mateuszwicinski/Awionika-SimBa/README.md

<h1>Awionika-SimBa - Modułowy komputer pokładowy rakiety (Altium Designer)</h1>

Projekt modułowego systemu elektroniki rakietowej wykonany w środowisku Altium Designer. Całość została zaprojektowana w formie 3-poziomowego, okrągłego stosu płytek drukowanych, dostosowanego kształtem do montażu wewnątrz kadłuba rakiety.

Poszczególne płytki łączą się ze sobą za pomocą złącz szpilkowych (goldpin), które przekazują linie zasilania oraz sygnały sterujące między poziomami.

<h2>Opis modułów systemu</h2>

<h3>Płytka dolna (Zasilanie i układy wykonawcze)</h3>

Odpowiada za zasilanie całego stosu oraz załączanie elementów wykonawczych:

Zasilanie: przetwornica step-down D30V30F5 dostarczająca główną linię 5V oraz stabilizator liniowy AMS1117 dla linii 3.3V. Wejście zasilania ze złącza XT30 lub ARK z diodą zabezpieczającą przed odwrotną polaryzacją.

Obwód zapalnika odzysku: wyjście śrubowe ARK sterowane tranzystorem N-MOSFET (AO3400A) z rezystorem ściągającym bramkę do masy. W gałąź zapalnika wpięty jest szeregowo bezpiecznik polimerowy 2.6A (0ZCG0260BF2B), którego zadaniem jest odcięcie dopływu prądu do zapalnika po zadziałaniu ładunku w razie zwarcia lub stopienia drutu oporowego, co chroni akumulator przed przeciążeniem i zapobiega wyłączeniu reszty elektroniki.

Obwód buzzera: tranzystor N-MOSFET (AO3400A) z diodą gaszącą impulsy indukcyjne (SS14) do załączania buzzera akustycznego po wylądowaniu.

Wyjścia serwomechanizmów: złącza JST-XH wyprowadzające linie zasilania 5V, masę oraz sygnały sterujące PWM.

<h3>Płytka środkowa (Logika i pamięć)</h3>

Główny moduł sterujący:

Mikrokontroler: płytka deweloperska ESP32-C3-Zero, połączona z magistralą między płytkami.

Karta pamięci: gniazdo modułu czytnika kart MicroSD (Waveshare) połączone przez interfejs SPI do zapisu parametrów lotu w czasie rzeczywistym.

<h3>Płytka górna (Sensory i łączność radiowa)</h3>

Moduł pomiarowy i komunikacyjny:

Moduł radiowy: LoRa z wyprowadzeniem pinu antenowego bezpośrednio do złącza antenowego J6.

Czujniki: pola pod moduł barometru oraz moduł czujnika IMU podłączone pod magistralę I2C/SPI.

Zawartość repozytorium

<h2>Dokumenty:</h2>

Schematy ideowe w formacie PDF dla każdego z trzech modułów.

Zestawienia komponentów (BOM) w formacie CSV.

Zrzuty i rendery 3D płytek drukowanych.

<h2>Fabryka:</h2>

Spakowane archiwa (ZIP) z plikami Gerber (warstwy miedzi, soldermaski, opisów i obrysu) oraz plikami wierceń maszynowych (NC Drill).

<h2>Projekty:</h2>

Pliki projektowe Altium Designer (.PrjPcb, .SchDoc, .PcbDoc).

Biblioteki symboli (.SchLib) oraz footprintów (.PcbLib) utworzone na potrzeby projektu.

<h2>Płytka logiki</h2>

Plytka_srodkowa_ESP_SD(bok1)

Plytka_srodkowa_ESP_SD(bok2)

Plytka_srodkowa_ESP_SD(tył)

Plytka_srodkowa_ESP_SD

<h2>Płytka LORA</h2>

Plytka_gorna_lora_czujniki(bok1)

Plytka_gorna_lora_czujniki(bok2)

Plytka_gorna_lora_czujniki(tyl)

Plytka_gorna_lora_czujniki

<h2>Płytka power</h2>

Plytka_dolna_power(bok1)

Plytka_dolna_power(bok2)

Plytka_dolna_power(tyl)

Plytka_dolna_power
