mateuszwicinski/Awionika-SimBa/Dokumenty/Zdjęcia/Projekt_Logika/Plytka_srodkowa_ESP_SD(bok1).png

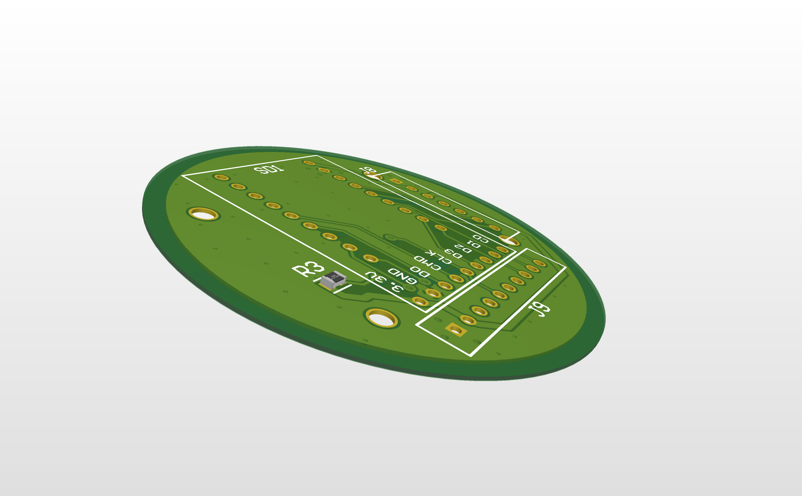
Dokumenty/Zdjęcia/Projekt_Logika/Plytka_srodkowa_ESP_SD(bok1).png
