mateuszwicinski/Awionika-SimBa/Dokumenty/Zdjęcia/Projekt_Logika/Plytka_srodkowa_ESP_SD(tył).png

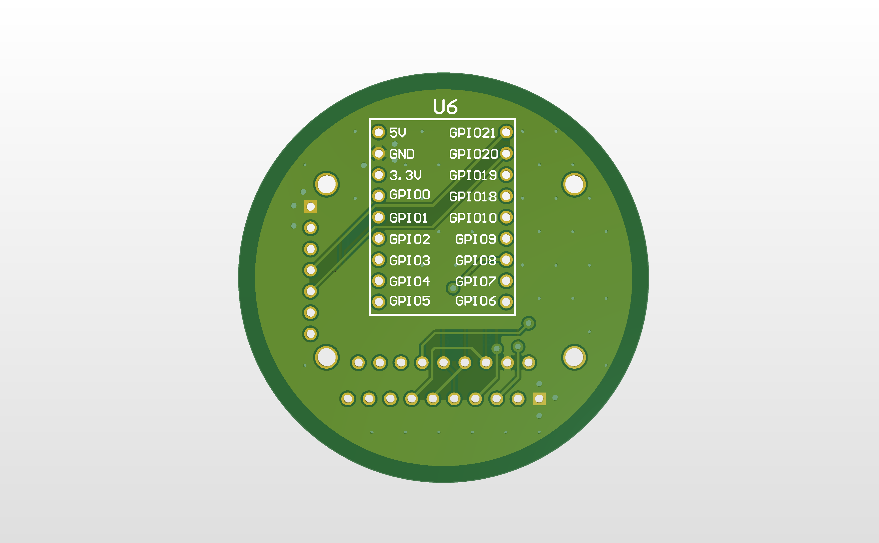
Dokumenty/Zdjęcia/Projekt_Logika/Plytka_srodkowa_ESP_SD(tył).png
