mateuszwicinski/Awionika-SimBa/Dokumenty/Zdjęcia/Projekt_LORA/Plytka_gorna_lora_czujniki(bok2).png

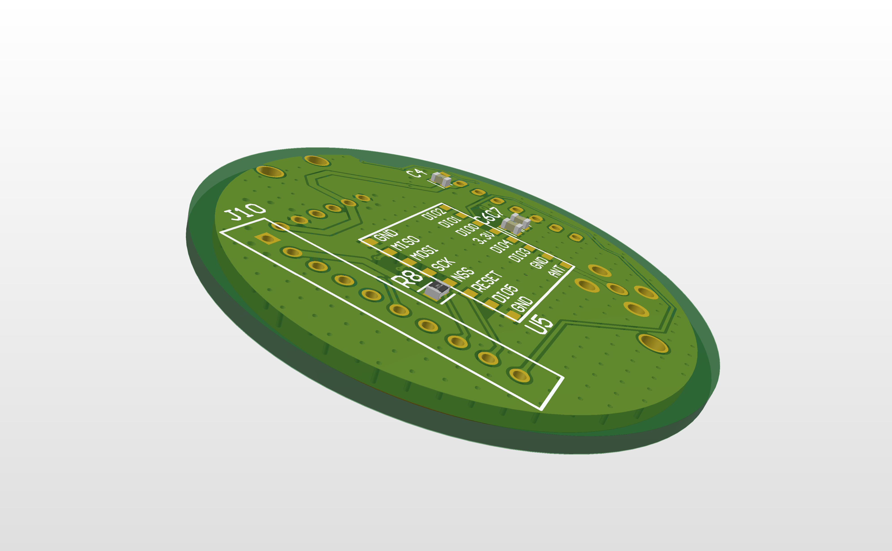
Dokumenty/Zdjęcia/Projekt_LORA/Plytka_gorna_lora_czujniki(bok2).png
