mateuszwicinski/Awionika-SimBa/Dokumenty/Zdjęcia/Projekt_LORA/Plytka_gorna_lora_czujniki(tyl).png

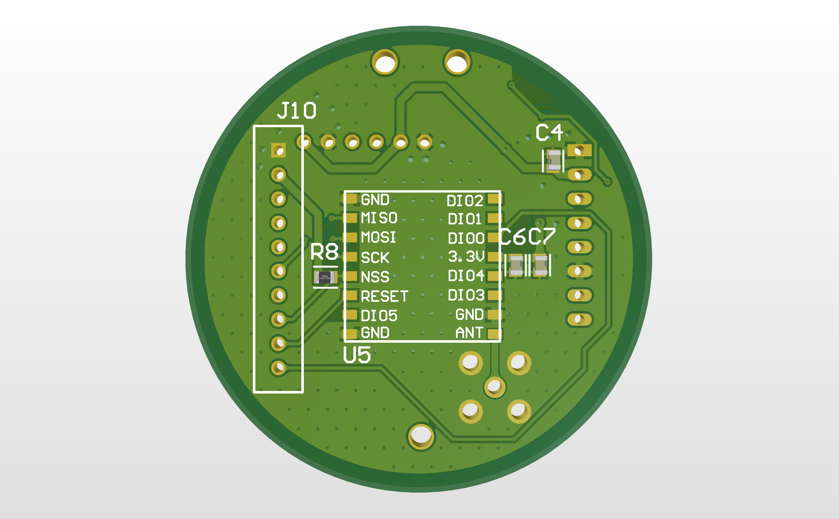
Dokumenty/Zdjęcia/Projekt_LORA/Plytka_gorna_lora_czujniki(tyl).png
