mateuszwicinski/Awionika-SimBa/Dokumenty/Zdjęcia/Projekt_LORA/Plytka_gorna_lora_czujniki.png

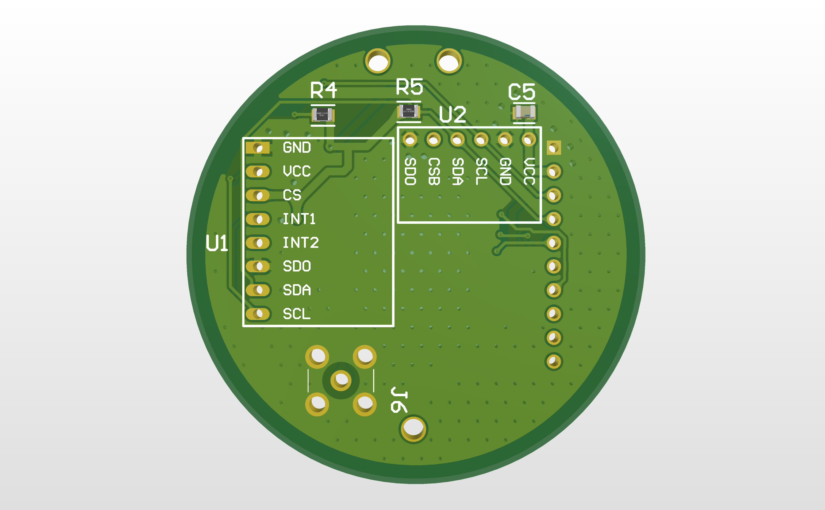
Dokumenty/Zdjęcia/Projekt_LORA/Plytka_gorna_lora_czujniki.png
