mateuszwicinski/Awionika-SimBa/Dokumenty/Zdjęcia/Projekt_Power/Plytka_dolna_power(bok1).png

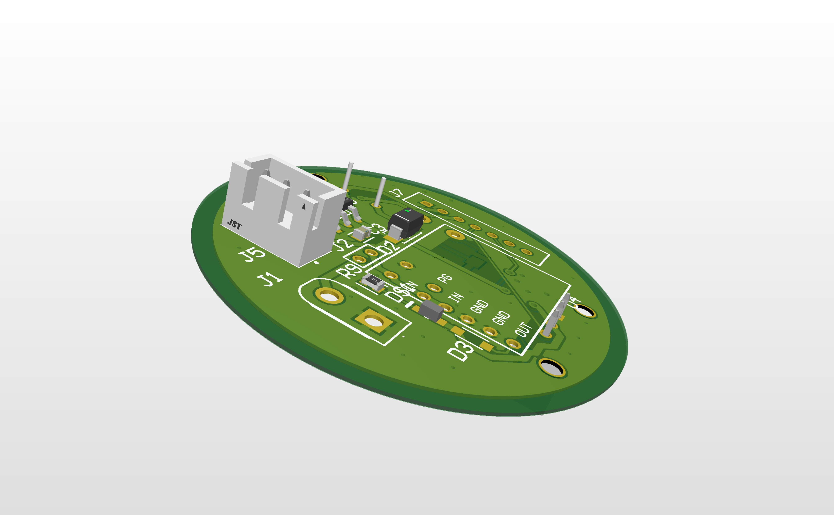
Dokumenty/Zdjęcia/Projekt_Power/Plytka_dolna_power(bok1).png
