mateuszwicinski/Awionika-SimBa/Dokumenty/Zdjęcia/Projekt_Power/Plytka_dolna_power(tyl).png

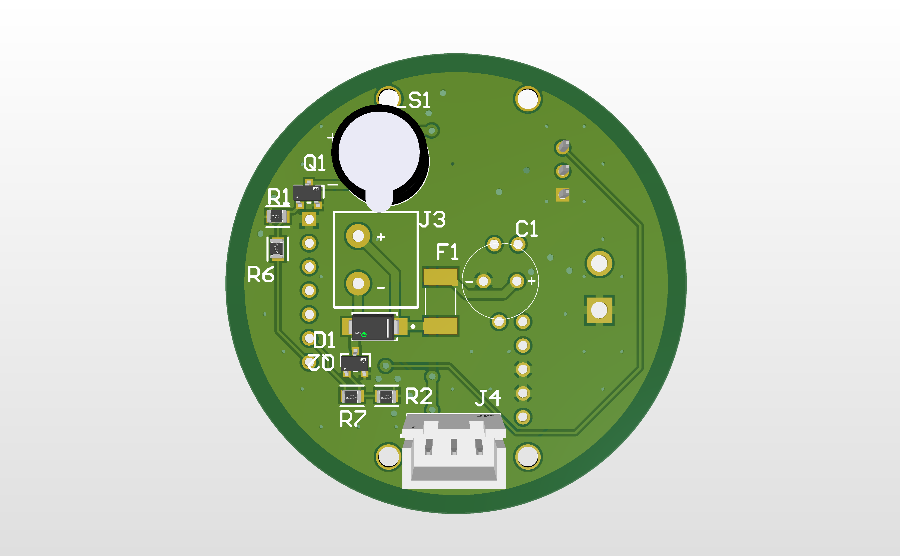
Dokumenty/Zdjęcia/Projekt_Power/Plytka_dolna_power(tyl).png
