mateuszwicinski/Awionika-SimBa/Dokumenty/BOM/Projekt_LORA.csv

Name | Description | Designator | Footprint | LibRef | Quantity
100nF | CAP CER 0.1UF 16V X7R 0805 | C4, C5, C7 | FP-C0805C-DN-MFG | CMP-2007-00274-2 | 3
10uF | CAP CER 10UF 16V X7R 0805 | C6 | FP-C0805C-DN-MFG | CMP-2007-00274-2 | 1
RF2-19A-T-00-50-G | Conn SMA 0Hz to 18GHz 50Ohm Solder ST Thru-Hole RCP Gold | J6 | RF219AT0050G | RF2-19A-T-00-50-G | 1
PrzejscieTHT10 |  | J10 | PrzejscieTHT10 | PrzejscieTHT10 | 1
4.7k? | CRGCQ 0805 4.7K 5% | R4, R5 | FP-CRGCQ0805-IPC_C | CMP-03211-002989-1 | 2
10k? | CRGCQ 0805 10K 5% | R8 | FP-CRGCQ0805-IPC_C | CMP-03211-002989-1 | 1
ADXL345 |  | U1 | ADXL345 | ADXL345 | 1
BMP280 |  | U2 | BMP280 | BMP280 | 1
RFM95W-868S2R |  | U5 | RFM95W-868S2R | RFM95W-868S2R | 1
