mateuszwicinski/Awionika-SimBa/Dokumenty/BOM/Projekt_Power.csv

Name | Description | Designator | Footprint | LibRef | Quantity
Kondensator_470uF/25V |  | C1 | Capacitor_470uF/25V | Kondensator_470uF/25V | 1
10uF | CAP CER 10UF 16V X7R 0805 | C2, C3 | FP-C0805C-DN-MFG | CMP-2007-00274-2 | 2
SS14 | DIODE SCHOTTKY 40V 1A SMA | D1, D2 | FP-403AE-MFG | CMP-2000-04943-2 | 2
SS34FA | UL Flammability 94V-0 Classification; MSL 1 per J-STD-020; Low Power Loss, High Efficiency; Guard Ring for Overvoltage Protection; RoHS Compliant / Green Molding Compound; High Surge Current Capability; NRVB Prefix for Automotive and Other Applications Requiring Unique Site and Control Change Requirements; AECQ101 Qualified and PPAP Capable | D3 | SODFL3618X143N | SS34FA | 1
KP-2012SGC | LED Green, 62.5 mW, 25 mA, -40 to 85 degC, 4-Pin SMD, RoHS, Tape and Reel | DS1, DS2 | KING-KP-2012SGC_V | CMP-2000-06517-1 | 2
0ZCG0260BF2B |  | F1 | FUSER_0ZCG0260BF2B | 0ZCG0260BF2B | 1
XT30PB-M | Brass Gold Plated Connector 0.65m , 500VDC , 15A , -20 to 120 | J1 | XT30PBM | XT30PB-M | 1
Zworka |  | J2 | Zworka | Zworka | 1
ARK_10A_300V |  | J3 | ARK_10A_300V | ARK_10A_300V | 1
B3B-XH-A(LF)(SN) | CONN HEADER VERT 3POS 2.5MM | J4, J5 | FP-B3B-XH-A_LF_SN-MFG | CMP-17439-000014-3 | 2
PrzejscieTHT |  | J7 | PrzejscieTHT | PrzejscieTHT | 1
LEB9055B-05B-2.7-5.0-R | AUDIO INDICATOR 3VDC 30MA 80DBA 2700HZ | LS1 | XDCR_AI-1027-TWT-3V-R | AI-1027-TWT-3V-R | 1
AO3400A | MOSFET N-CH 30V 5.7A SOT23 | Q1, Q2 | FP-SOT23-MFG | CMP-83955-000006-1 | 2
10k? | CRGCQ 0805 10K 5% | R1, R2 | FP-CRGCQ0805-IPC_C | CMP-03211-002989-1 | 2
100? | CRGCQ 0805 100 5% | R6, R7 | FP-CRGCQ0805-IPC_C | CMP-03211-002989-1 | 2
1k? | CRGCQ 0805 1K 5% | R9, R10 | FP-CRGCQ0805-IPC_C | CMP-03211-002989-1 | 2
ams1117 | 1A LOW DROPOUT VOLTAGE REGULATOR | U3 | FP-ams1117-IPC_C | CMP-209535-000002-1 | 1
D30V30F5 |  | U4 | D30V30F5 | D30V30F5 | 1
