mateuszwicinski/Awionika-SimBa/Projekty/Plytka_dolna_power.pdf

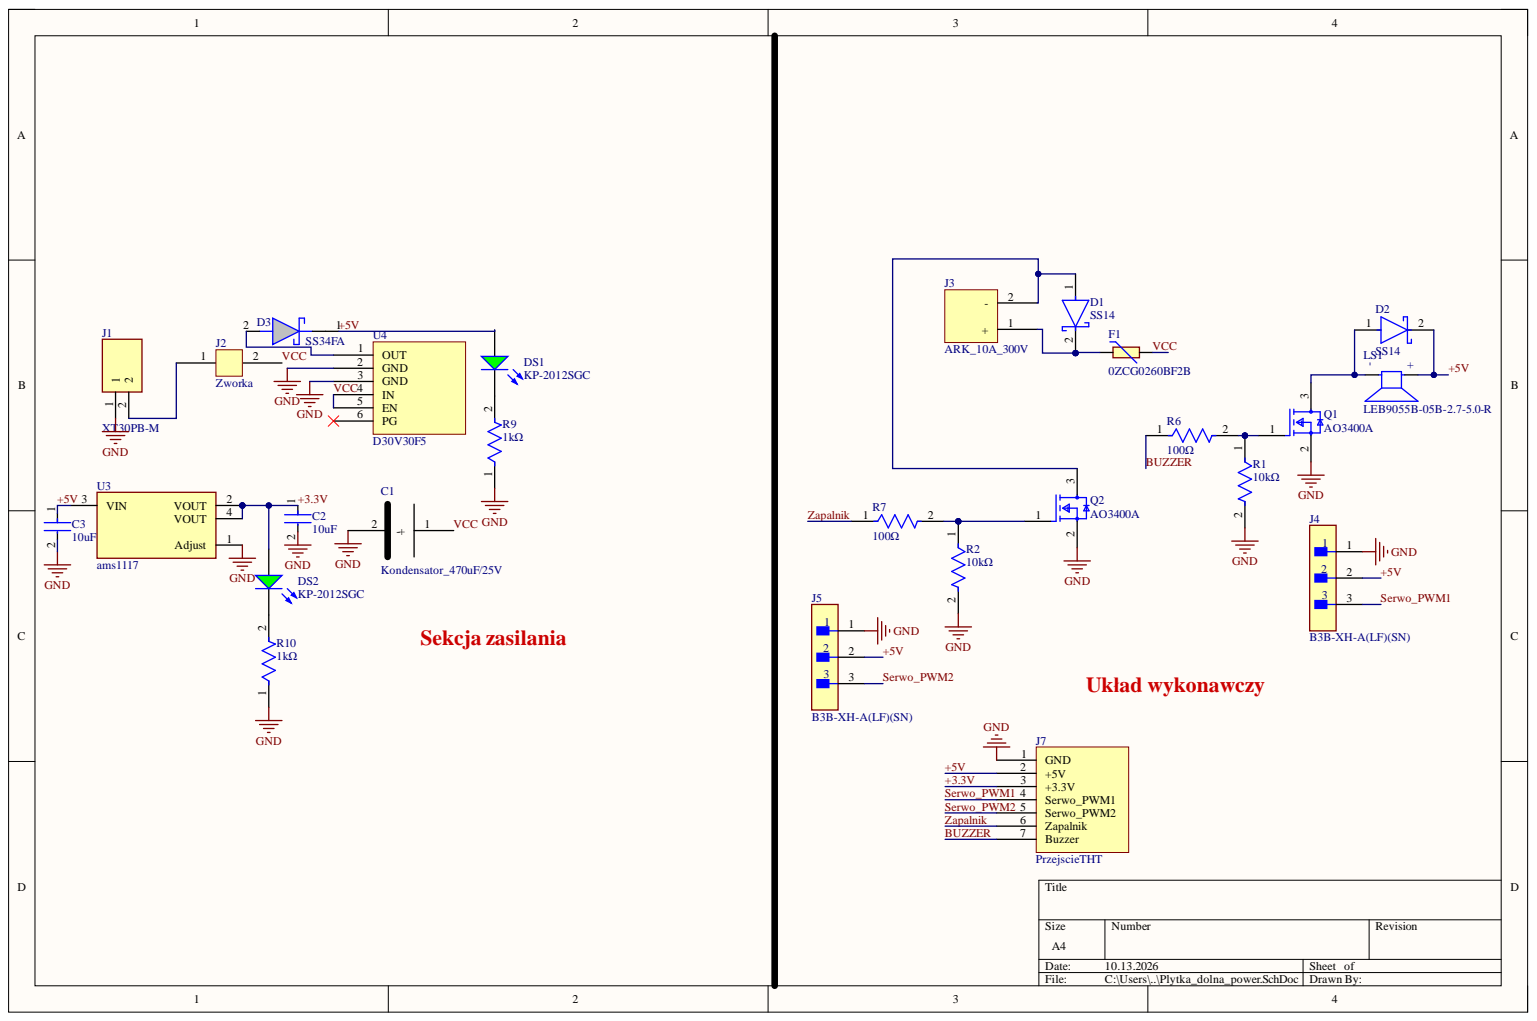
[picture p12: page 1]
