mateuszwicinski/Awionika-SimBa/Projekty/Plytka_gorna_lora_czujniki.pdf

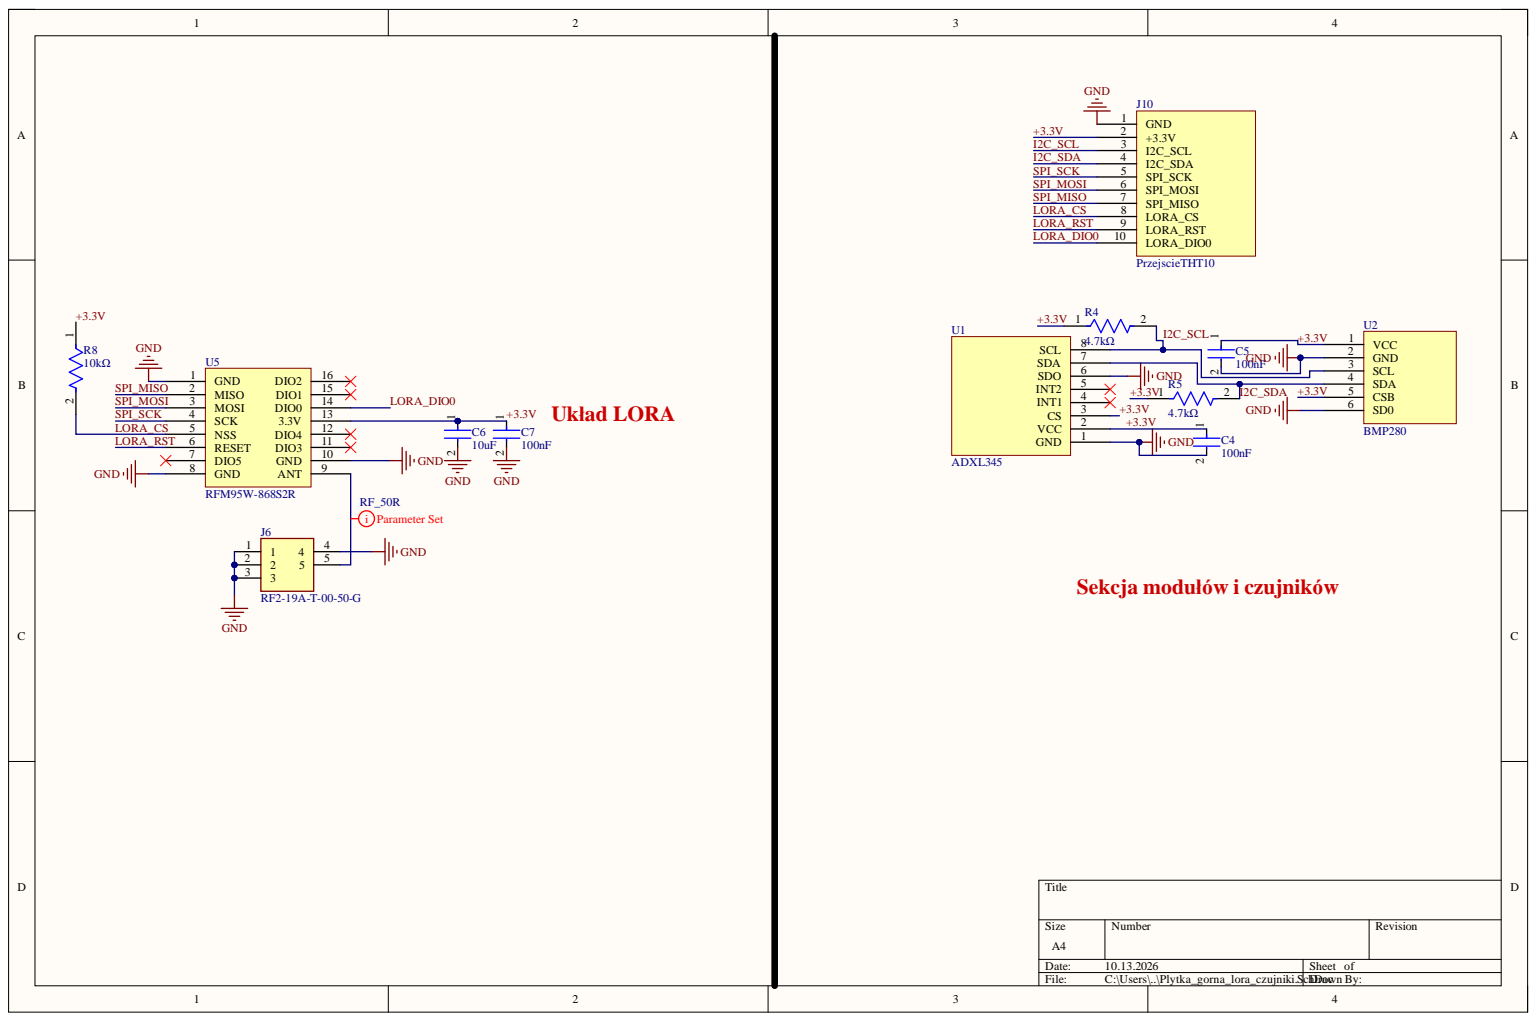
[picture p13: page 1]
