mateuszwicinski/Awionika-SimBa/Projekty/Plytka_srodkowa_ESP_SD.pdf

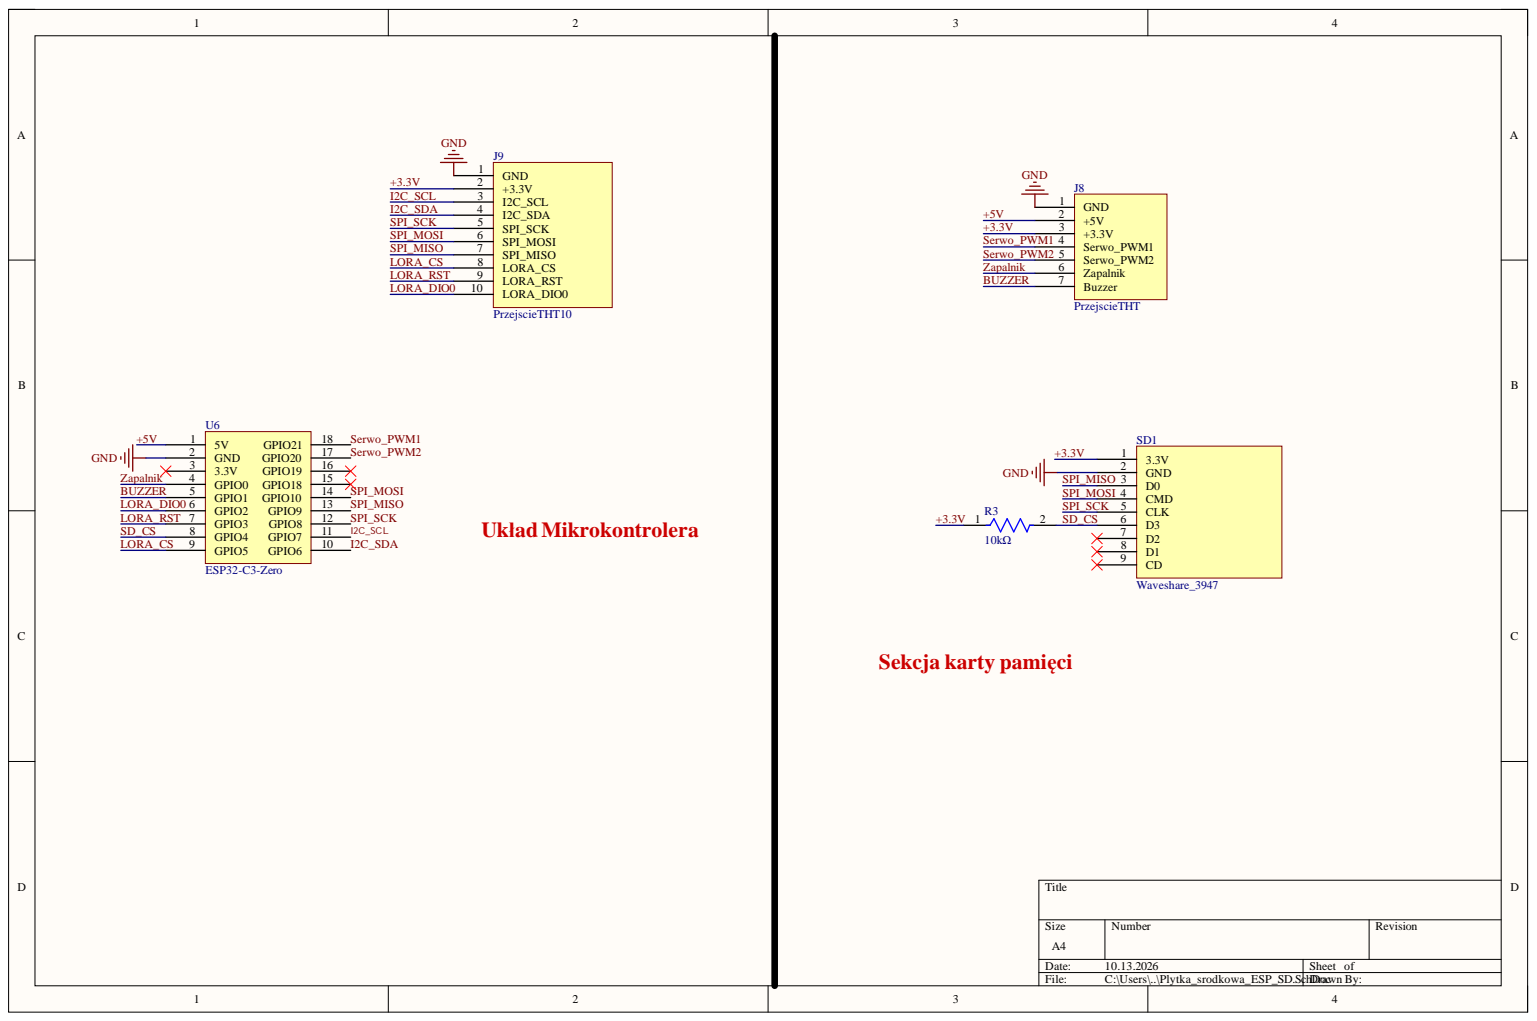
[picture p14: page 1]
