mateuszwicinski/Awionika-SimBa/Projekty/Projekt_Power.pdf

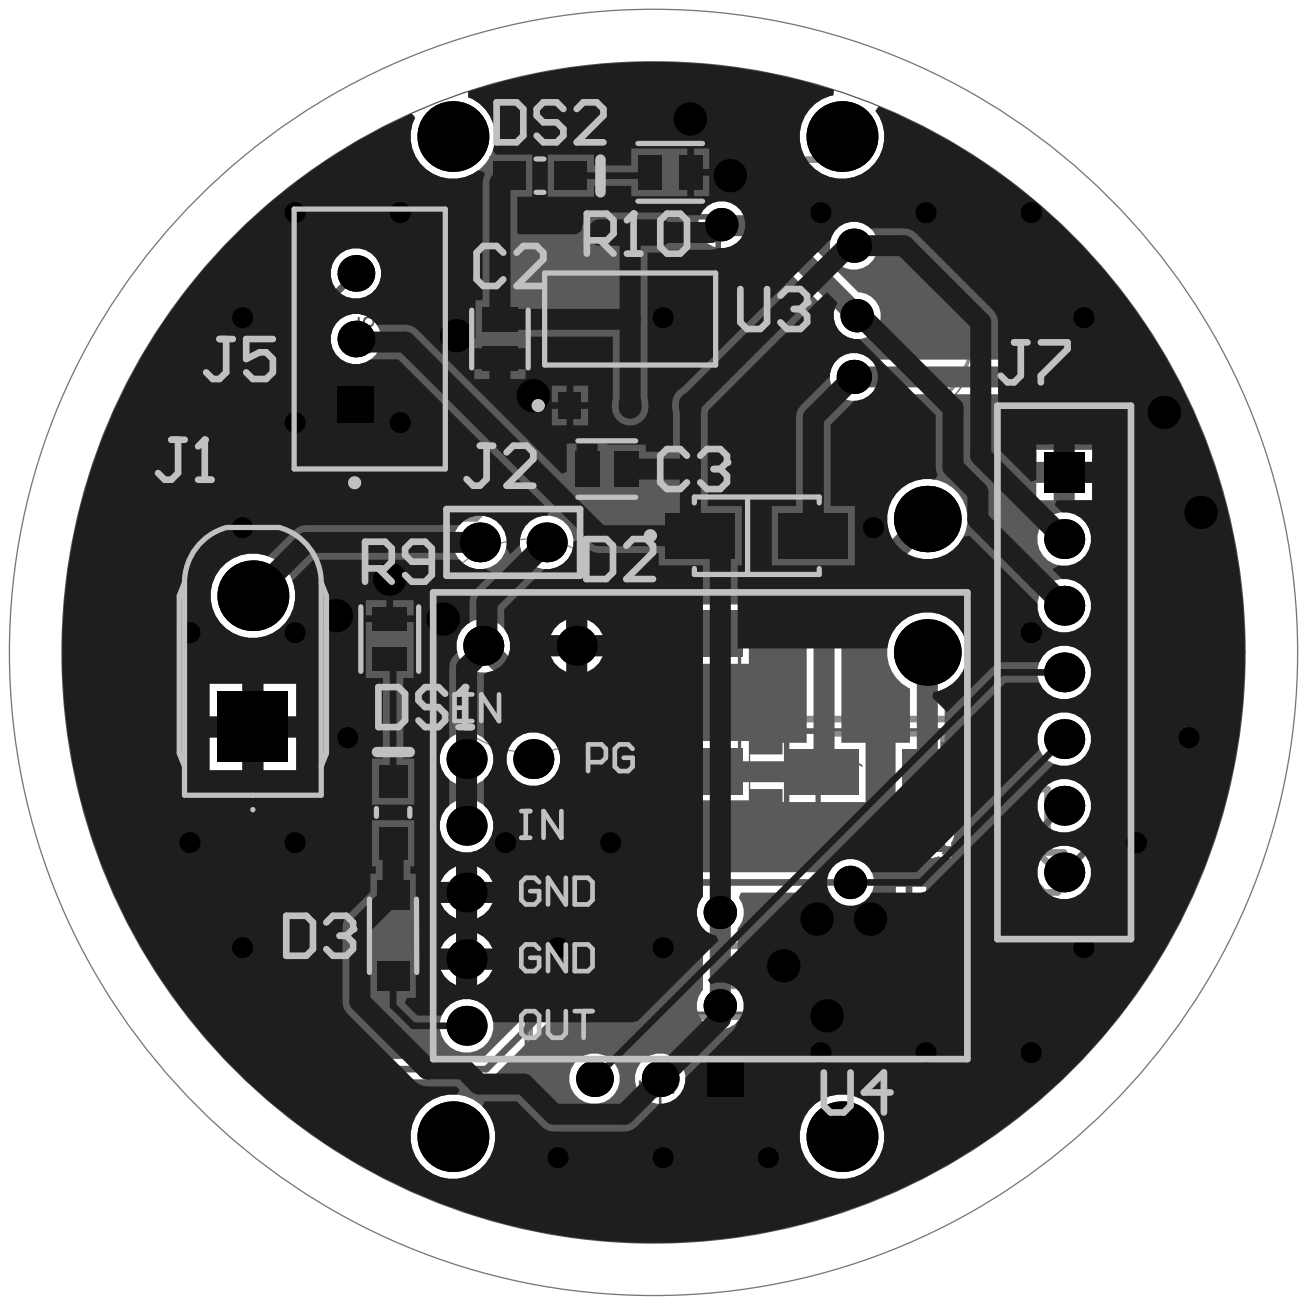
[picture p15: page 2]
