mateuszwicinski/Awionika-SimBa/(list of files, drawings)

Other design files:
Projekty/Akcelerometr.PcbLib
Projekty/Akcelerometr.SchLib
Projekty/Barometr.PcbLib
Projekty/Barometr.SchLib
Projekty/Buzzer.PcbLib
Projekty/Buzzer.SchLib
Projekty/CzytnikKartSD.PcbLib
Projekty/CzytnikKartSD.SchLib
Projekty/Kondensator_470uF_25V.PcbLib
Projekty/Kondensator_470uF_25V.SchLib
Projekty/LEB9055B-05B-2.7-5.0-R.PcbLib
Projekty/LEB9055B-05B-2.7-5.0-R.SchLib
Projekty/LORA.PcbLib
Projekty/LORA.SchLib
Projekty/Mikrokontroler.PcbLib
Projekty/Mikrokontroler.SchLib
Projekty/Plytka_dolna_power.SchDoc
Projekty/Plytka_gorna_lora_czujniki.PcbDoc
Projekty/Plytka_gorna_lora_czujniki.SchDoc
Projekty/Plytka_power.PcbDoc
Projekty/Plytka_srodkowa_ESP_SD.PcbDoc
Projekty/Plytka_srodkowa_ESP_SD.SchDoc
Projekty/Projekt_Logika.PrjPcb
Projekty/Projekt_LORA.PrjPcb
Projekty/Projekt_Power.PrjPcb
Projekty/PrzejścieTHT10.PcbLib
Projekty/PrzejścieTHT10.SchLib
Projekty/PrzejścieTHT.PcbLib
Projekty/PrzejścieTHT.SchLib
Projekty/PrzetwornicaBOOST.PcbLib
Projekty/PrzetwornicaBOOST.SchLib
Projekty/PrzetwornicaStepDOWN.PcbLib
Projekty/PrzetwornicaStepDOWN.SchLib
Projekty/Serwomechanizm.PcbLib
Projekty/Serwomechanizm.SchLib
Projekty/StabilizatorNapiecia.PcbLib
Projekty/StabilizatorNapiecia.SchLib
Projekty/XT30PB-M.SchLib
Projekty/XT30PBM.PcbLib
Projekty/Zlacze_ARK.PcbLib
Projekty/Zlacze_ARK.SchLib
Projekty/Zworka.PcbLib
Projekty/Zworka.SchLib
